kuantienho/FoldDeckCase/images/dimensioned-layout.png

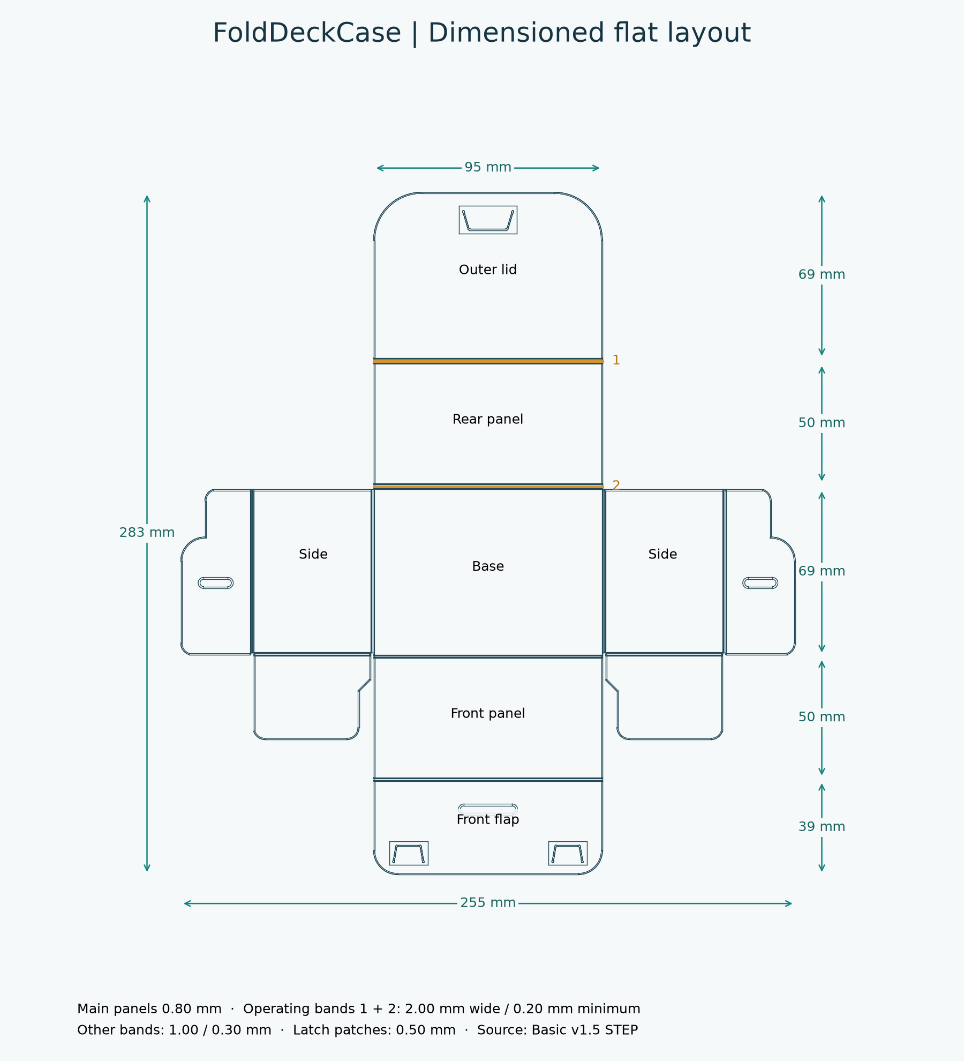
images/dimensioned-layout.png
