kuantienho/FoldDeckCase/images/flat-cad.png

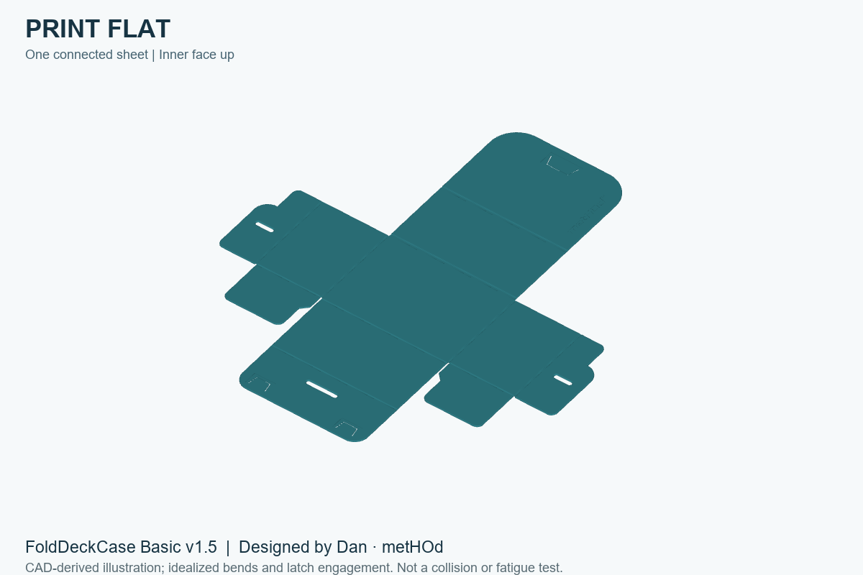
images/flat-cad.png
