kuantienho/FoldDeckCase/images/inner-lid-signature.png

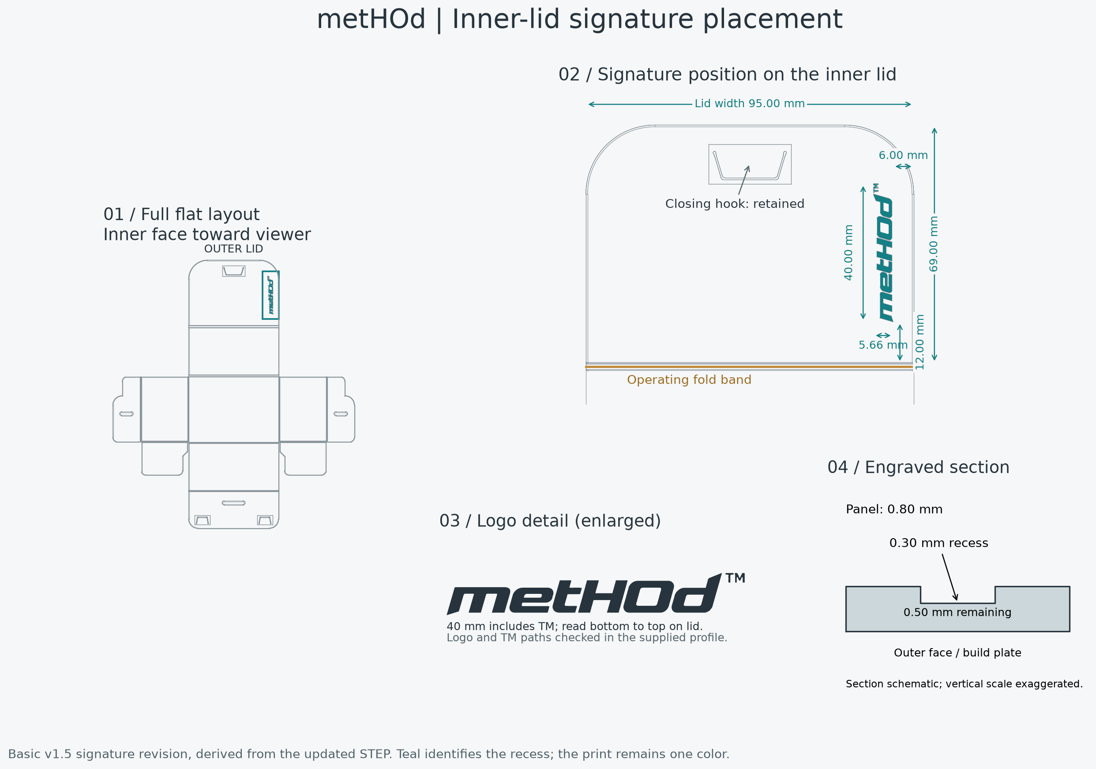
images/inner-lid-signature.png
