kuantienho/FoldDeckCase/cad/foldeckcasev1.5_metHOd.step

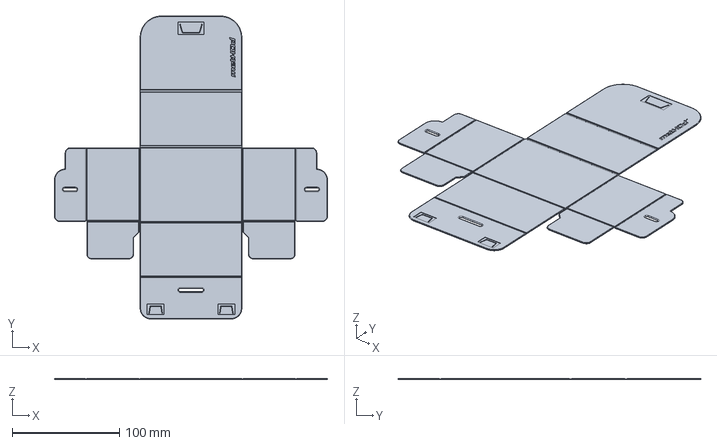
[picture p13: CAD file, 2026-10-20]
cad/foldeckcasev1.5_metHOd.step
255.0 x 283.0 x 0.8 mm
