kuantienho/FoldDeckCase/(list of files, cad)

Other CAD files:
cad/foldeckcasev1.5.step
print/foldeckcasev1.5.3mf
print/foldeckcasev1.5_metHOd.3mf
