kuantienho/FoldDeckCase/images/assembled-cad.png

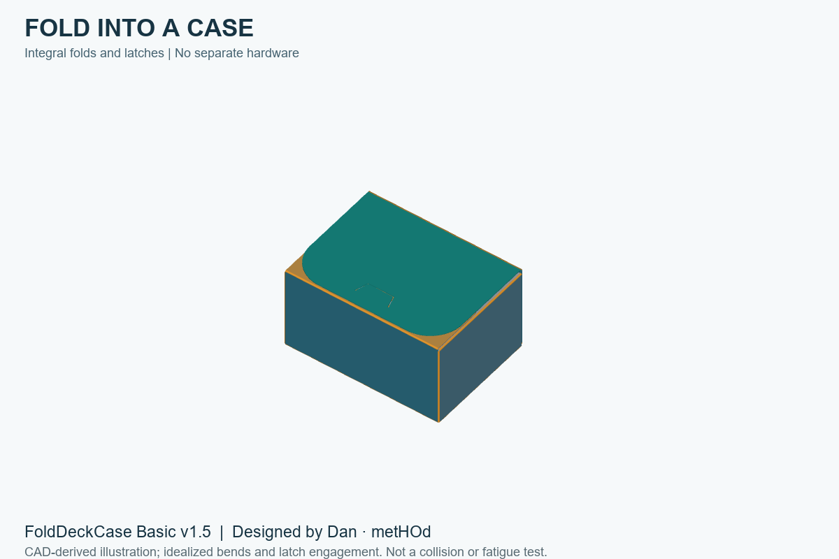
images/assembled-cad.png
