kuantienho/FoldDeckCase/RELEASE_NOTES.md

# Basic v1.5 — metHOd signature revision

Updated October 20, 2026.

- Added a 40.00 × 5.66 mm inner-lid wordmark with enlarged TM.
- Engraved 0.30 mm deep, leaving 0.50 mm beneath the mark.
- Kept the outer envelope, folds, latches, and original fast-print settings.
- Updated STEP and 3MF: `foldeckcasev1.5_metHOd`.
- Checked valid single-solid CAD, watertight mesh, and successful Bambu Studio slicing/export.
- Seven layers; total estimate 1 h 33 min 2 s, model estimate 1 h 26 min 7 s, material estimate 40.75 g.
- Physical print validation is still pending for the engraved revision. The original v1.5 was successfully printed.

The original `foldeckcasev1.5.step` and `.3mf` remain available for the previously printed, unsigned design. Third-party artwork is not included in this repository update.

---

# FoldDeckCase Basic v1.5

A thin, single-piece card carrier that prints flat and folds into shape.

- One plate, no separate assembly hardware, and no supports for Basic.
- Seven-layer A1 profile: approximately 1 h 33 min and 40.79 g in the slicer.
- Editable STEP model and Bambu Studio 3MF project included.
- Extended and rounded slit roots on all three latches, with resized flexible patches.

Open the 3MF as a project and check your printer, plate, and material before slicing. Keep the saved orientation and scale.

Basic v1.5 was successfully printed, as reported by the designer on October 20, 2026. Earlier prototypes were also assembled successfully. No quantified fatigue, retention-force, or load rating is claimed.

Included CAD-derived illustrations and animation explain the folding sequence. Flexible latch engagement is idealized; the animation is not a dynamic interference test.
