kuantienho/FoldDeckCase/(commit log)

2026-10-20 Add files via upload
    Add FoldDeckCase Basic v1.5 design, print profile, and documentation
    [foldeckcasev1.5.3mf, foldeckcasev1.5.step]
2026-10-20 Publish Basic v1.5 files, CAD assembly visuals, and print validation update
    [foldeckcasev1.5.3mf, foldeckcasev1.5.step]
2026-10-20 Add metHOd inner-lid signature revision and updated print documentation
    [foldeckcasev1.5_metHOd.3mf, foldeckcasev1.5_metHOd.step]
2026-10-20 Refocus product overview and add three dimensioned CAD views
